AlpenglowIndustries/Alpenglow_ChillySnowCloud_PCB/README.md

# Alpenglow_ChillySnowCloud_PCB
Kicad files for Chilly Snow Cloud beginning soldering PCB
