AlpenglowIndustries/Alpenglow_ChillySnowCloud_PCB/Artwork/BrrrFaceThicker.png

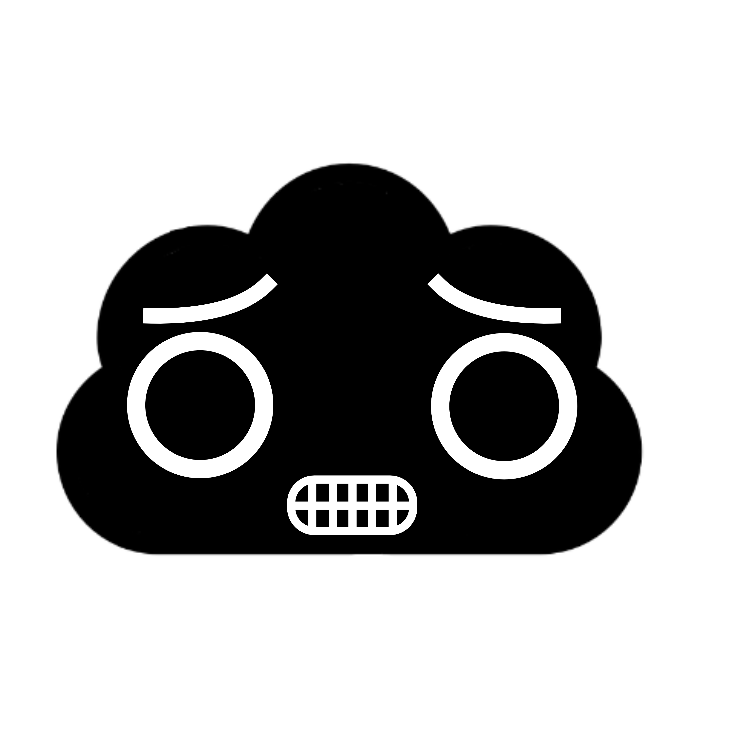
Artwork/BrrrFaceThicker.png
