AlpenglowIndustries/Alpenglow_ChillySnowCloud_PCB/Artwork/CSC board name font Long.png

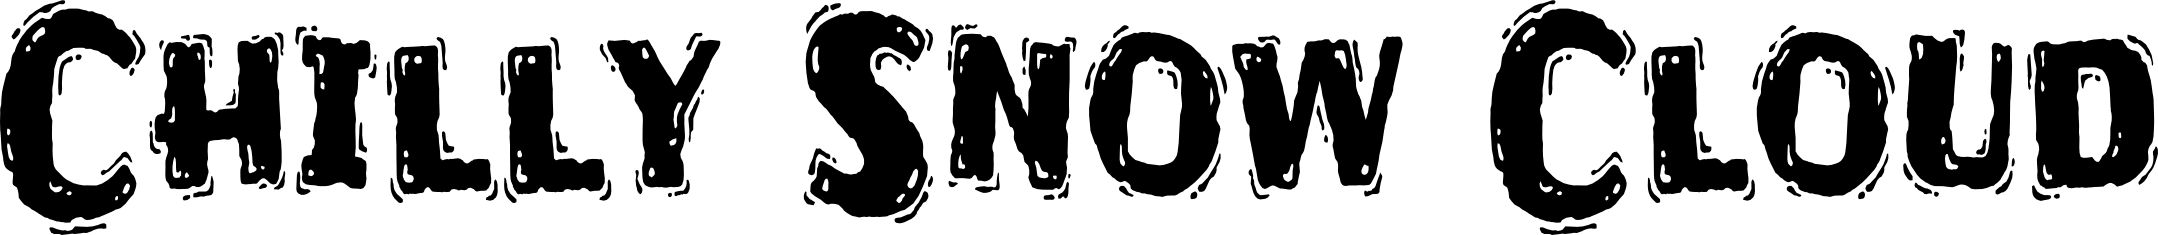
Artwork/CSC board name font Long.png
