AlpenglowIndustries/Alpenglow_ChillySnowCloud_PCB/Artwork/SnowFlake2.png

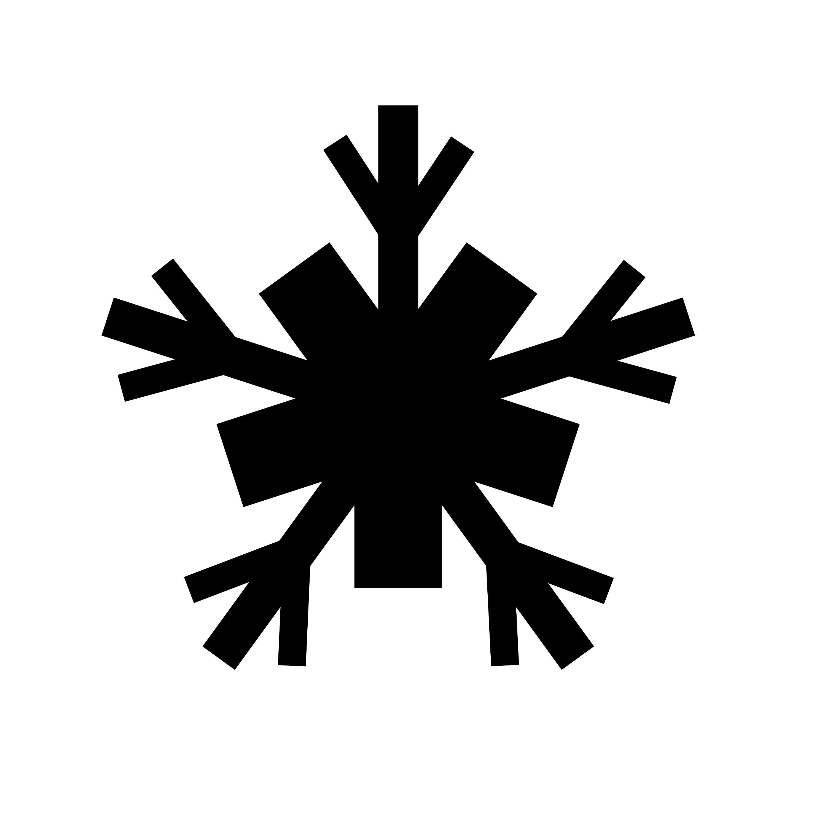
Artwork/SnowFlake2.png
