AlpenglowIndustries/Alpenglow_ChillySnowCloud_PCB/ChillySnowCloud BOM Instructions.csv

Line | RefDes | Type | Qty Kit | Qty PCB | Description | Manufacturer | Manufacturer Part No
1 | BT1, | CONN | 1 | 1 | Through hole, CR2032 battery holder | PengPeng Components Store
2 | D1, D2, D3, | LED | 4 | 3 | Self flashing, 5mm blue thorugh hole LEDs | Mosleader
3 | SW1, | SWITCH | 1 | 1 | Right angle slide switch, SPDT, through hole | xin cheng electronic | SK12D07VG3
4 |  |  | 1 | 0 | Adhesive-backed pin
5 |  |  | 1 | 0 | Magnet | YuLe
6 |  |  | 1 | 0 | CR2032, coin cell battery | pkcell | AG4
7
