AlpenglowIndustries/Alpenglow_ChillySnowCloud_PCB/Alpenglow_ChillySnowCloud_PCB.pdf

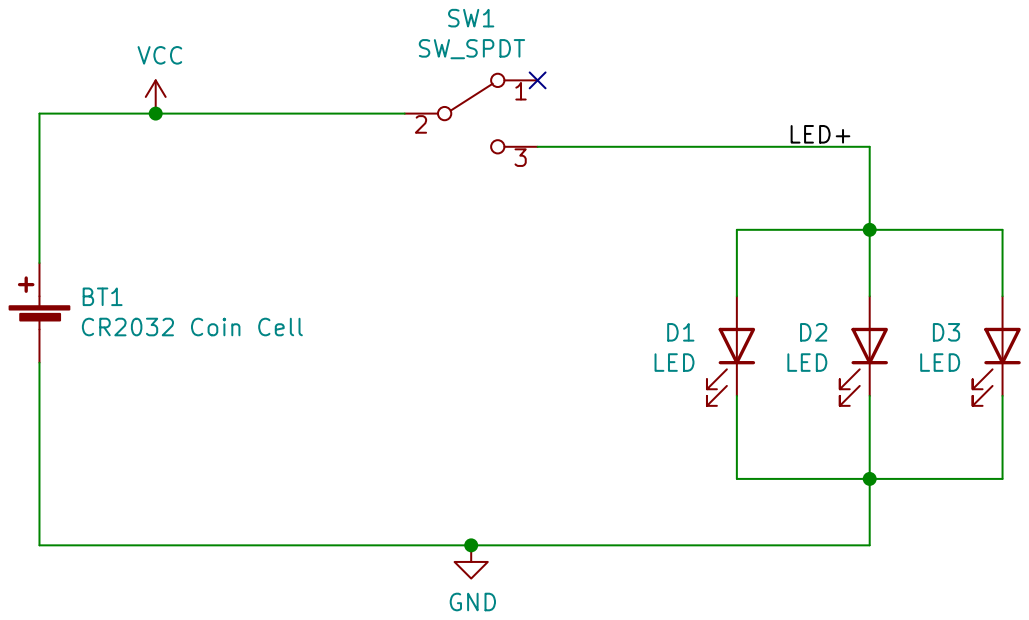
[picture p4: page 1]

File: Alpenglow_ChillySnowCloud_PCB.kicad_sch Sheet: / CSC-0100 WRIGHT

Id: 1/1 Title: Chilly Snow Cloud
