AlpenglowIndustries/Alpenglow_ChillySnowCloud_PCB/(commit log)

2022-04-01 Initial commit of all Kicad files
    [Alpenglow_ChillySnowCloud_AllSilver_PCB-B_Cu.gbr, Alpenglow_ChillySnowCloud_AllSilver_PCB-B_Mask.gbr, Alpenglow_ChillySnowCloud_AllSilver_PCB-B_SilkS.gbr, Alpenglow_ChillySnowCloud_AllSilver_PCB-Edge_Cuts.gbr, Alpenglow_ChillySnowCloud_AllSilver_PCB-F_Cu.gbr, Alpenglow_ChillySnowCloud_AllSilver_PCB-F_Mask.gbr, Alpenglow_ChillySnowCloud_AllSilver_PCB-NPTH.drl, Alpenglow_ChillySnowCloud_AllSilver_P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]
2022-06-01 Update Final Design
    [Alpenglow_ChillySnowCloud_AllSilver_PCB.kicad_pcb, Alpenglow_ChillySnowCloud_OnlySilverSnowflakes_PCB.kicad_pcb, Alpenglow_ChillySnowCloud_PCB.sch]
2022-06-06 removed unused layouts, fixed some short track stubs, generated gerbers
    [Alpenglow_ChillySnowCloud_AllSilver_PCB-B_Cu.gbr, Alpenglow_ChillySnowCloud_AllSilver_PCB-B_Mask.gbr, Alpenglow_ChillySnowCloud_AllSilver_PCB-B_SilkS.gbr, Alpenglow_ChillySnowCloud_AllSilver_PCB-F_Cu.gbr, Alpenglow_ChillySnowCloud_AllSilver_PCB-F_Mask.gbr, Alpenglow_ChillySnowCloud_AllSilver_PCB-NPTH.drl, Alpenglow_ChillySnowCloud_AllSilver_PCB-PTH.drl, Alpenglow_ChillySnowCloud_AllSilver_PCB-job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]
2022-06-07 Added GND to switch mntg holes, generated gerbers
    [Alpenglow_ChillySnowCloud_PCB-B_Cu.gbr, Alpenglow_ChillySnowCloud_PCB-B_Mask.gbr, Alpenglow_ChillySnowCloud_PCB-B_Silkscreen.gbr, Alpenglow_ChillySnowCloud_PCB-Edge_Cuts.gbr, Alpenglow_ChillySnowCloud_PCB-F_Cu.gbr, Alpenglow_ChillySnowCloud_PCB-F_Mask.gbr, Alpenglow_ChillySnowCloud_PCB-F_Silkscreen.gbr, Alpenglow_ChillySnowCloud_PCB-NPTH.drl]
2022-09-15 Updated board name with font, used oswald font @alpenglowind
    [Alpenglow_ChillySnowCloud_PCB.kicad_pcb, Alpenglow_ChillySnowCloud_PCB.kicad_sch]
2022-09-21 fixed .sch file with last good one, added .zip to gitignore
    [Alpenglow_ChillySnowCloud_PCB.kicad_sch]
2022-09-21 Updated switch footprint
    [Alpenglow_ChillySnowCloud_PCB.kicad_pcb, Alpenglow_ChillySnowCloud_PCB.kicad_sch]
2022-10-27 updated BOM, Schematic PDF
    [ChillySnowCloud BOM Instructions.xlsx]
2022-10-27 Updated gitignore, changed BOM to CSV file
    [ChillySnowCloud BOM Instructions.csv, ChillySnowCloud BOM Instructions.xlsx]
2024-01-03 Updated Switch, Added hole on top for hanging, Removed GND pur and added GND traces, Updated artwork
    [Alpenglow_ChillySnowCloud_PCB.kicad_pcb, Alpenglow_ChillySnowCloud_PCB.kicad_sch]
2024-01-12 cleaned up some traces
    [Alpenglow_ChillySnowCloud_PCB.kicad_pcb]
2024-01-16 Updated LED footprint, Changed via to mounting hole
    [Alpenglow_ChillySnowCloud_PCB.kicad_pcb, Alpenglow_ChillySnowCloud_PCB.kicad_sch]
2024-01-19 added fab notes, generated gerbers
    [Alpenglow_ChillySnowCloud_PCB-B_Cu.gbr, Alpenglow_ChillySnowCloud_PCB-B_Mask.gbr, Alpenglow_ChillySnowCloud_PCB-B_Silkscreen.gbr, Alpenglow_ChillySnowCloud_PCB-Edge_Cuts.gbr, Alpenglow_ChillySnowCloud_PCB-F_Cu.gbr, Alpenglow_ChillySnowCloud_PCB-F_Mask.gbr, Alpenglow_ChillySnowCloud_PCB-F_Silkscreen.gbr, Alpenglow_ChillySnowCloud_PCB-NPTH.drl]
2024-01-19 hid LED refdes & text, re-generated gerbers
    [Alpenglow_ChillySnowCloud_PCB-B_Cu.gbr, Alpenglow_ChillySnowCloud_PCB-B_Mask.gbr, Alpenglow_ChillySnowCloud_PCB-B_Silkscreen.gbr, Alpenglow_ChillySnowCloud_PCB-Edge_Cuts.gbr, Alpenglow_ChillySnowCloud_PCB-F_Cu.gbr, Alpenglow_ChillySnowCloud_PCB-F_Mask.gbr, Alpenglow_ChillySnowCloud_PCB-F_Silkscreen.gbr, Alpenglow_ChillySnowCloud_PCB-NPTH.drl]
